MicroRally/Isolator-Controller/README.md

# Isolator Controller
 Isolator relay controller
