MicroRally/Isolator-Controller/Hardware/r4/Isolator_controller_r4_MODEL.step

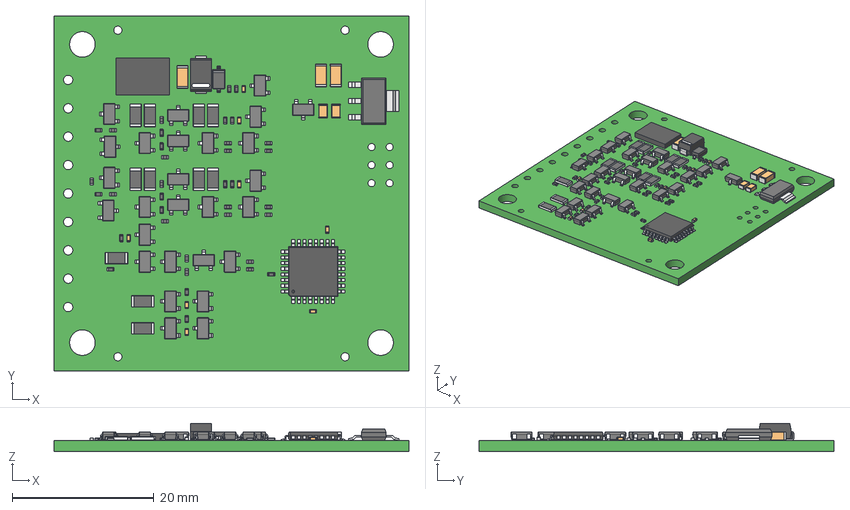
[picture p1: CAD file, 2021-09-15]
Hardware/r4/Isolator_controller_r4_MODEL.step
50.0 x 50.0 x 4.01 mm
SOT23-3 x 27
DO214AC-SMA
RESC0402_v2 x 36
SOT223-3 x 5
TQFP_32
RESC1206_v1 x 11
Extruded
pin
pin(Mirror)
icbody
C0402_045 x 24
C0805_085 x 6
C1206_120 x 9
