MicroRally/Isolator-Controller/Hardware/r5/Isolator_controller_r5_MODEL.step

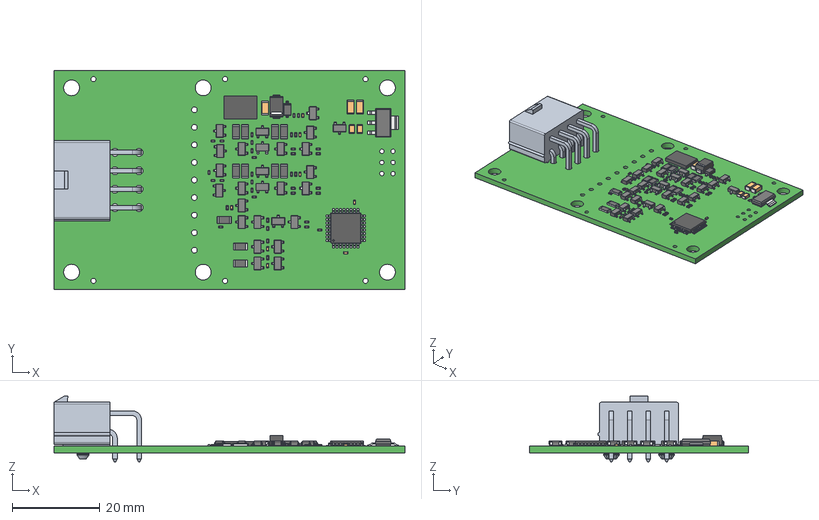
[picture p2: CAD file, 2022-07-29]
Hardware/r5/Isolator_controller_r5_MODEL.step
80.0 x 50.0 x 15.0 mm
SOT23-3 x 27
DO214AC-SMA
RESC0402_v2 x 36
SOT223-3 x 5
TQFP_32
RESC1206_v1 x 11
Extruded
pin
pin(Mirror)
icbody
C0402_045 x 24
C0805_085 x 6
C1206_120 x 9
