MicroRally/Isolator-Controller/Hardware/r5/Isolator_controller_r5_PCB.PDF

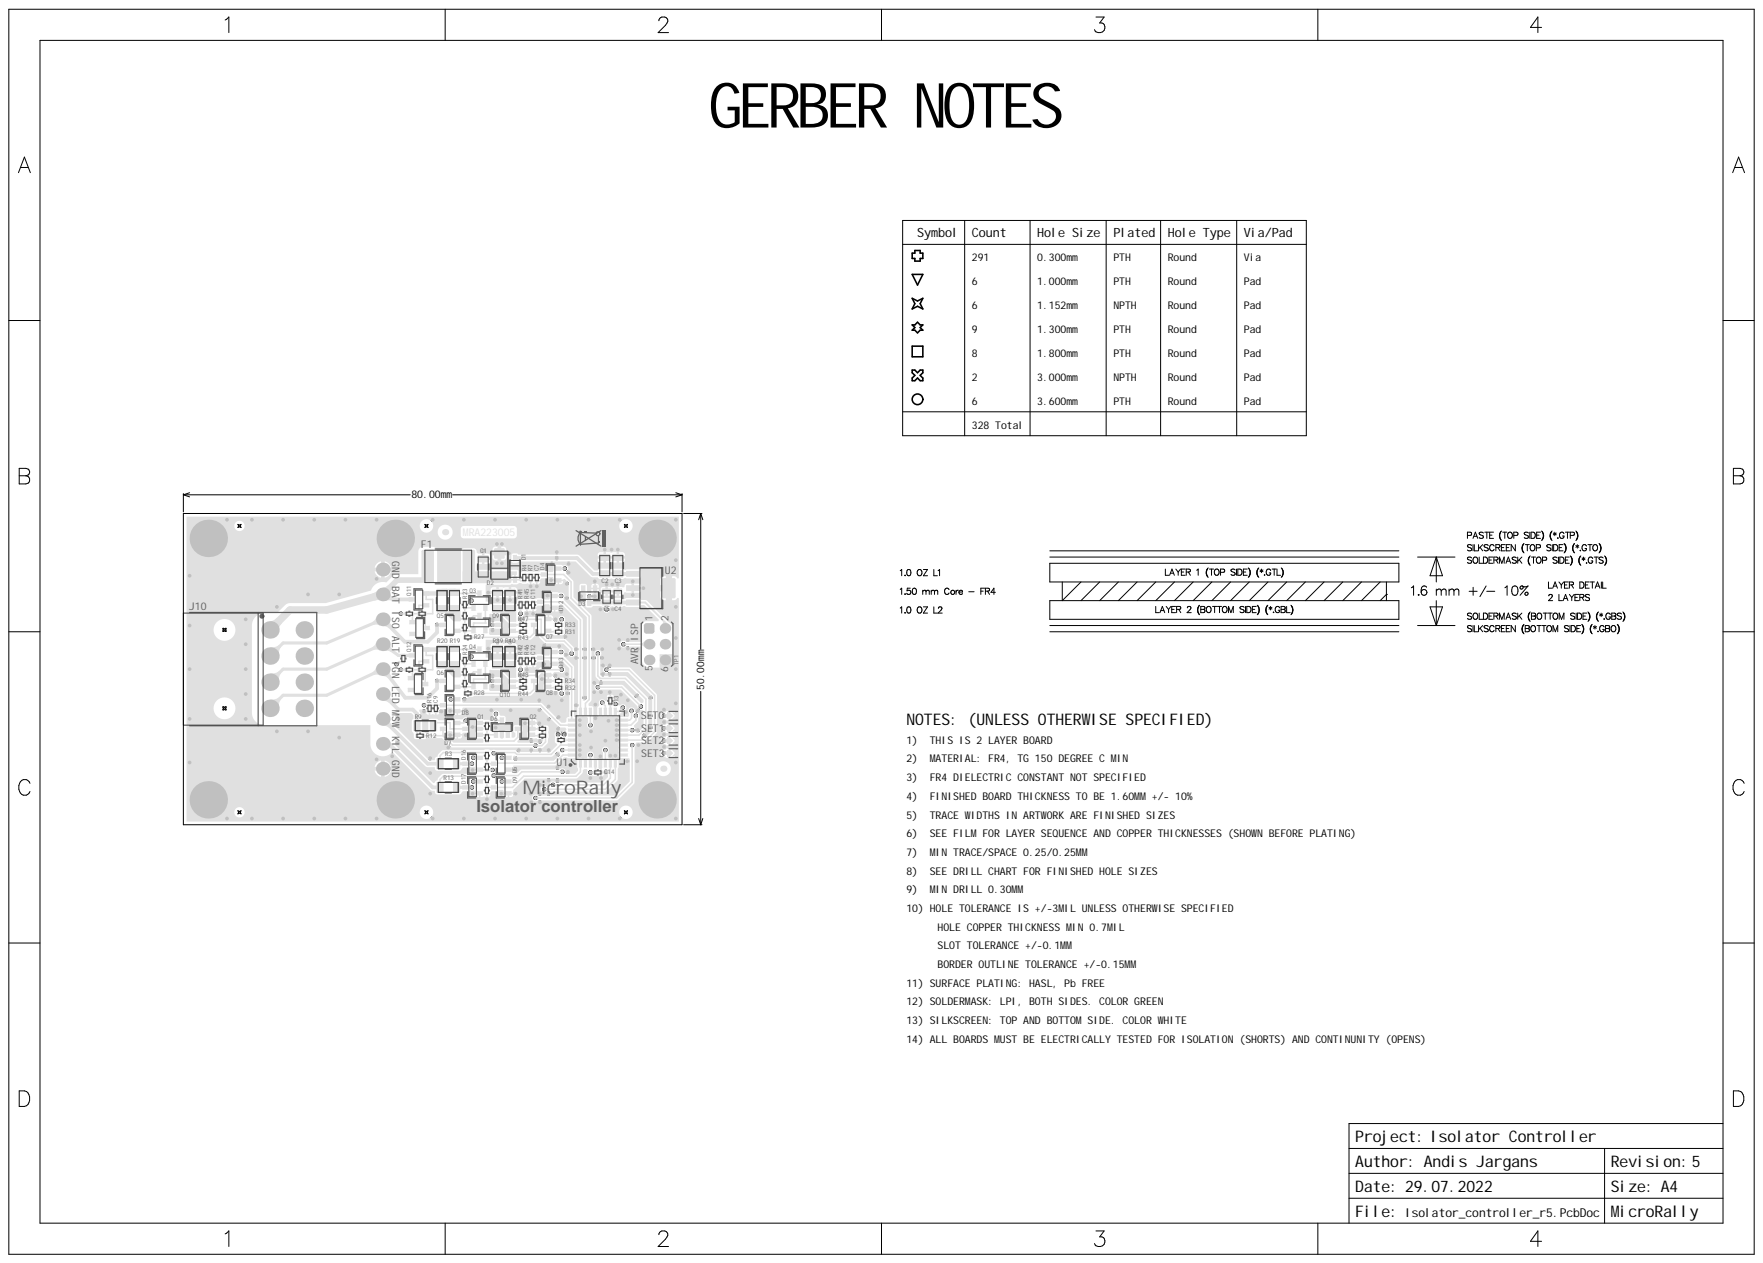
[picture p3: page 1]

Symbol | Count | Hole Size | Plated | Hole Type | Via/Pad

291 6 6 9 8 2 6 | 0.300mm 1.000mm 1.152mm 1.300mm 1.800mm 3.000mm 3.600mm | PTH PTH NPTH PTH PTH NPTH PTH | Round Round Round Round Round Round Round | Via Pad Pad Pad Pad Pad Pad

328 Total

GND BAT ISO ALT IGN LED MSW KIL GND

NOTES: (UNLESS OTHERWISE SPECIFIED)

1) THIS IS 2 LAYER BOARD
2) MATERIAL: FR4, TG 150 DEGREE C MIN
3) FR4 DIELECTRIC CONSTANT NOT SPECIFIED
4) FINISHED BOARD THICKNESS TO BE 1.60MM +/- 10%
5) TRACE WIDTHS IN ARTWORK ARE FINISHED SIZES
6) SEE FILM FOR LAYER SEQUENCE AND COPPER THICKNESSES (SHOWN BEFORE PLATING)
7) MIN TRACE/SPACE 0.25/0.25MM
8) SEE DRILL CHART FOR FINISHED HOLE SIZES
9) MIN DRILL 0.30MM
10) HOLE TOLERANCE IS +/-3MIL UNLESS OTHERWISE SPECIFIED
HOLE COPPER THICKNESS MIN 0.7MIL
SLOT TOLERANCE +/-0.1MM
BORDER OUTLINE TOLERANCE +/-0.15MM
11) SURFACE PLATING: HASL, Pb FREE
12) SOLDERMASK: LPI, BOTH SIDES. COLOR GREEN
13) SILKSCREEN: TOP AND BOTTOM SIDE. COLOR WHITE
14) ALL BOARDS MUST BE ELECTRICALLY TESTED FOR ISOLATION (SHORTS) AND CONTINUNITY (OPENS)

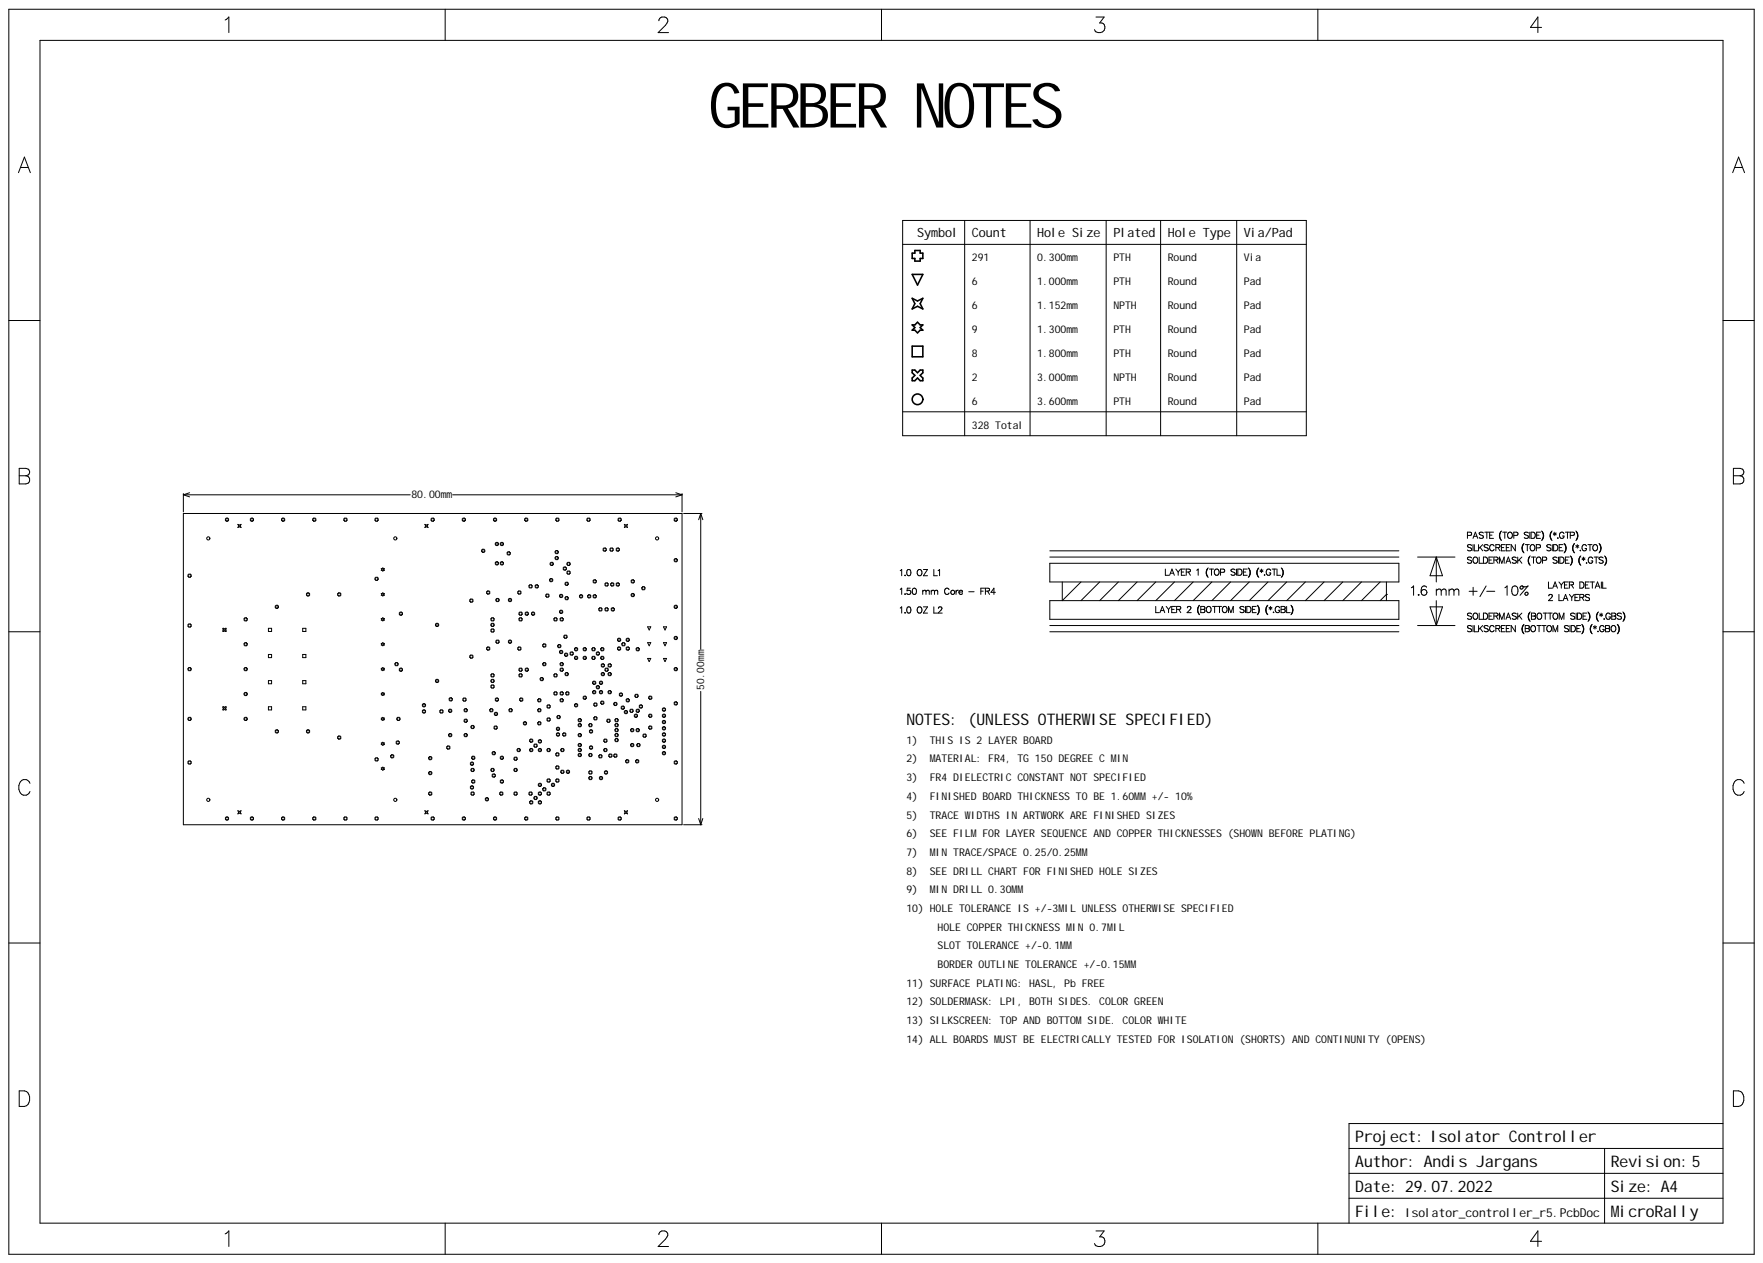
[picture p4: page 2]

Symbol | Count | Hole Size | Plated | Hole Type | Via/Pad

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

328 Total

NOTES: (UNLESS OTHERWISE SPECIFIED)

1) THIS IS 2 LAYER BOARD
2) MATERIAL: FR4, TG 150 DEGREE C MIN
3) FR4 DIELECTRIC CONSTANT NOT SPECIFIED
4) FINISHED BOARD THICKNESS TO BE 1.60MM +/- 10%
5) TRACE WIDTHS IN ARTWORK ARE FINISHED SIZES
6) SEE FILM FOR LAYER SEQUENCE AND COPPER THICKNESSES (SHOWN BEFORE PLATING)
7) MIN TRACE/SPACE 0.25/0.25MM
8) SEE DRILL CHART FOR FINISHED HOLE SIZES
9) MIN DRILL 0.30MM
10) HOLE TOLERANCE IS +/-3MIL UNLESS OTHERWISE SPECIFIED
HOLE COPPER THICKNESS MIN 0.7MIL
SLOT TOLERANCE +/-0.1MM
BORDER OUTLINE TOLERANCE +/-0.15MM
11) SURFACE PLATING: HASL, Pb FREE
12) SOLDERMASK: LPI, BOTH SIDES. COLOR GREEN
13) SILKSCREEN: TOP AND BOTTOM SIDE. COLOR WHITE
14) ALL BOARDS MUST BE ELECTRICALLY TESTED FOR ISOLATION (SHORTS) AND CONTINUNITY (OPENS)

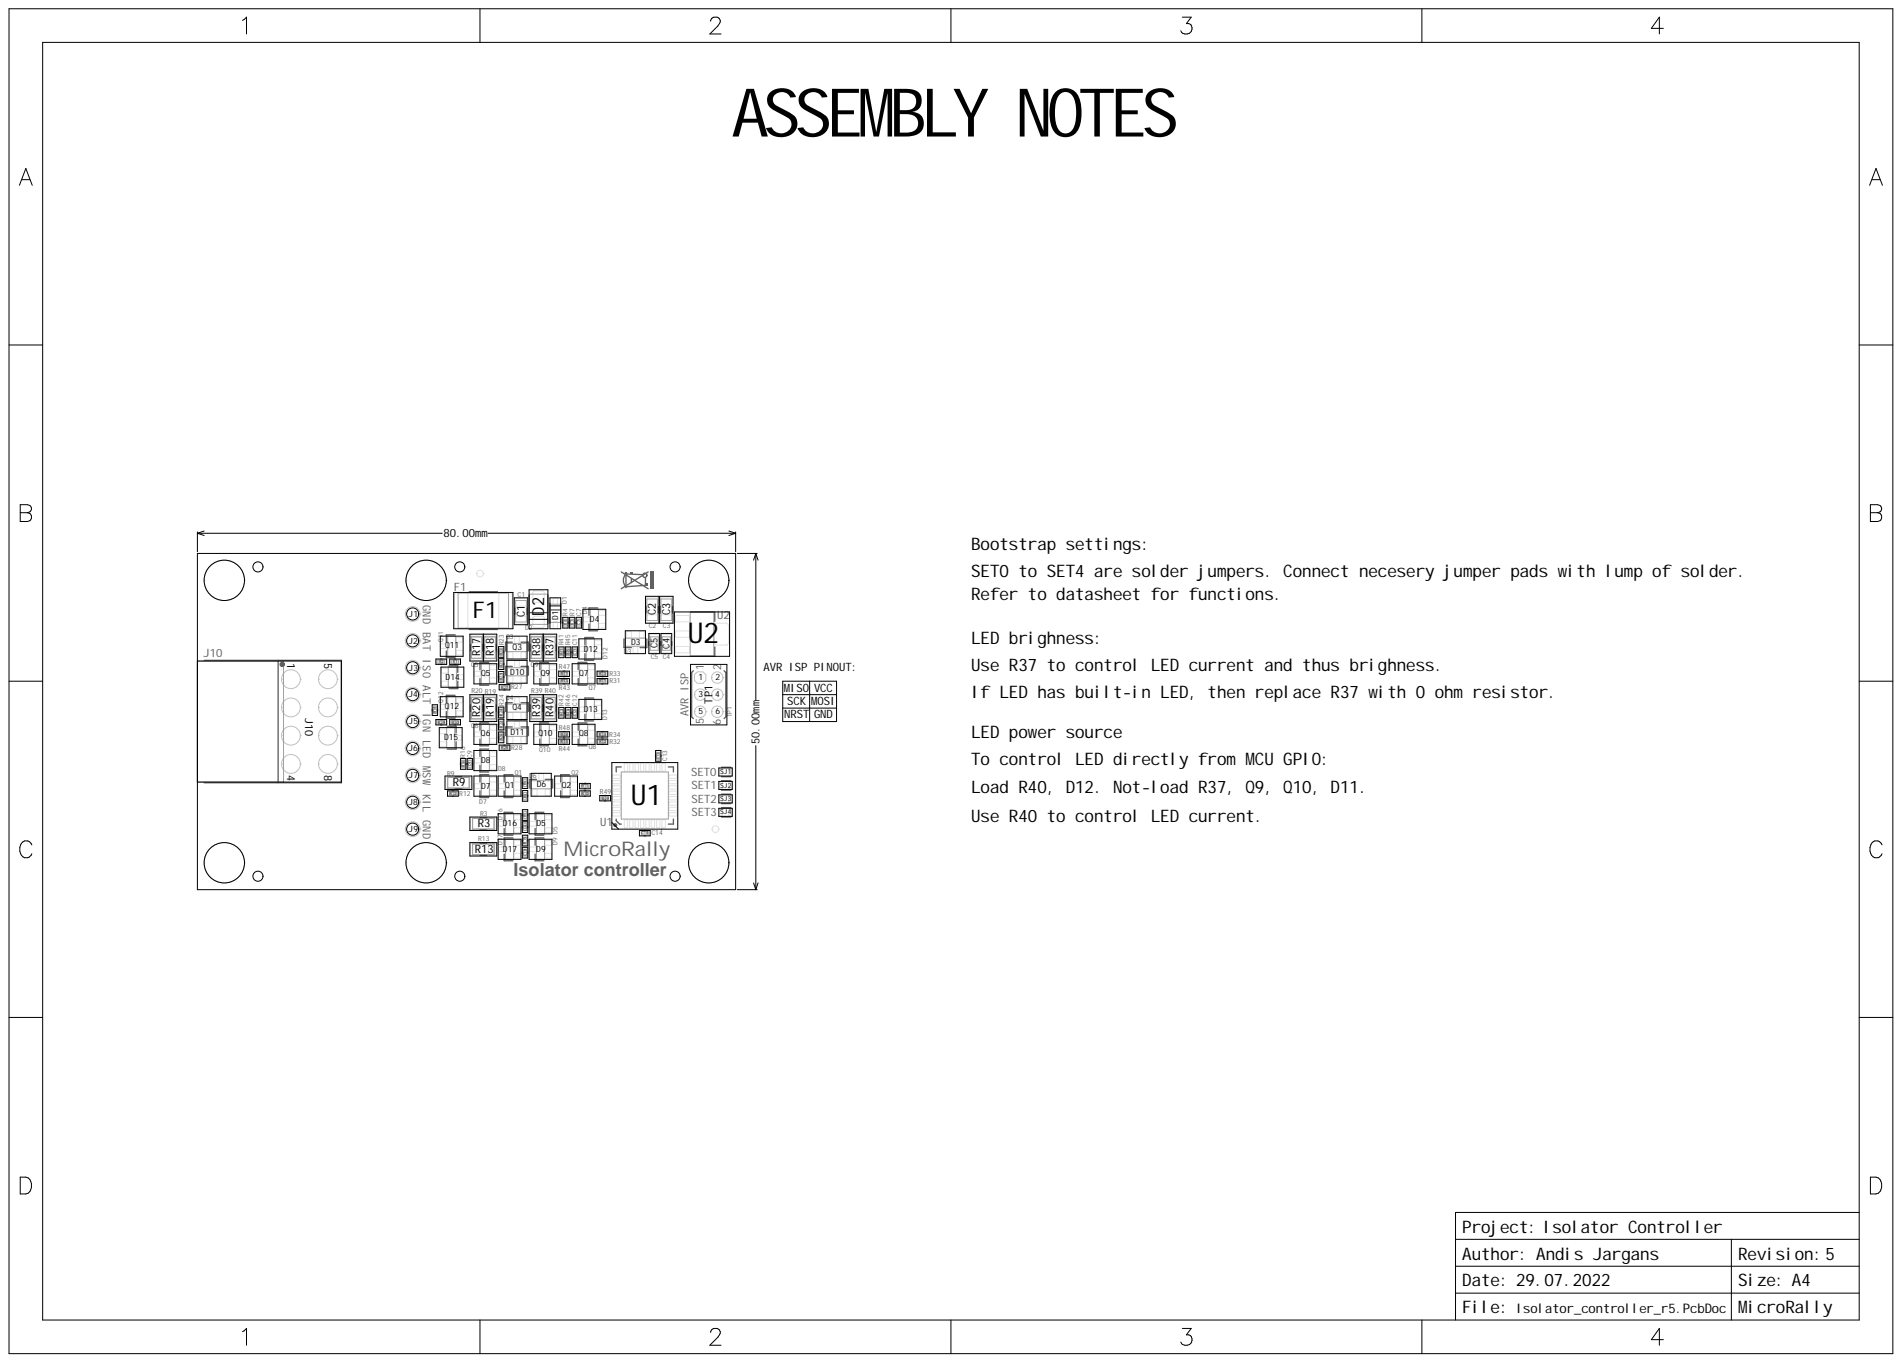
[picture p5: page 3]

Bootstrap settings:
SET0 to SET4 are solder jumpers. Connect necesery jumper pads with lump of solder.
Refer to datasheet for functions.

GND BAT ISO ALT IGN LED MSW KIL GND

LED brighness:
Use R37 to control LED current and thus brighness.

If LED has built-in LED, then replace R37 with 0 ohm resistor.

LED power source
To control LED directly from MCU GPIO:
Load R40, D12. Not-load R37, Q9, Q10, D11.
Use R40 to control LED current.

Author: Andis Jargans | Revision: 5
Date: 29.07.2022 | Size: A4

File: Isolator_controller_r5.PcbDoc | MicroRally

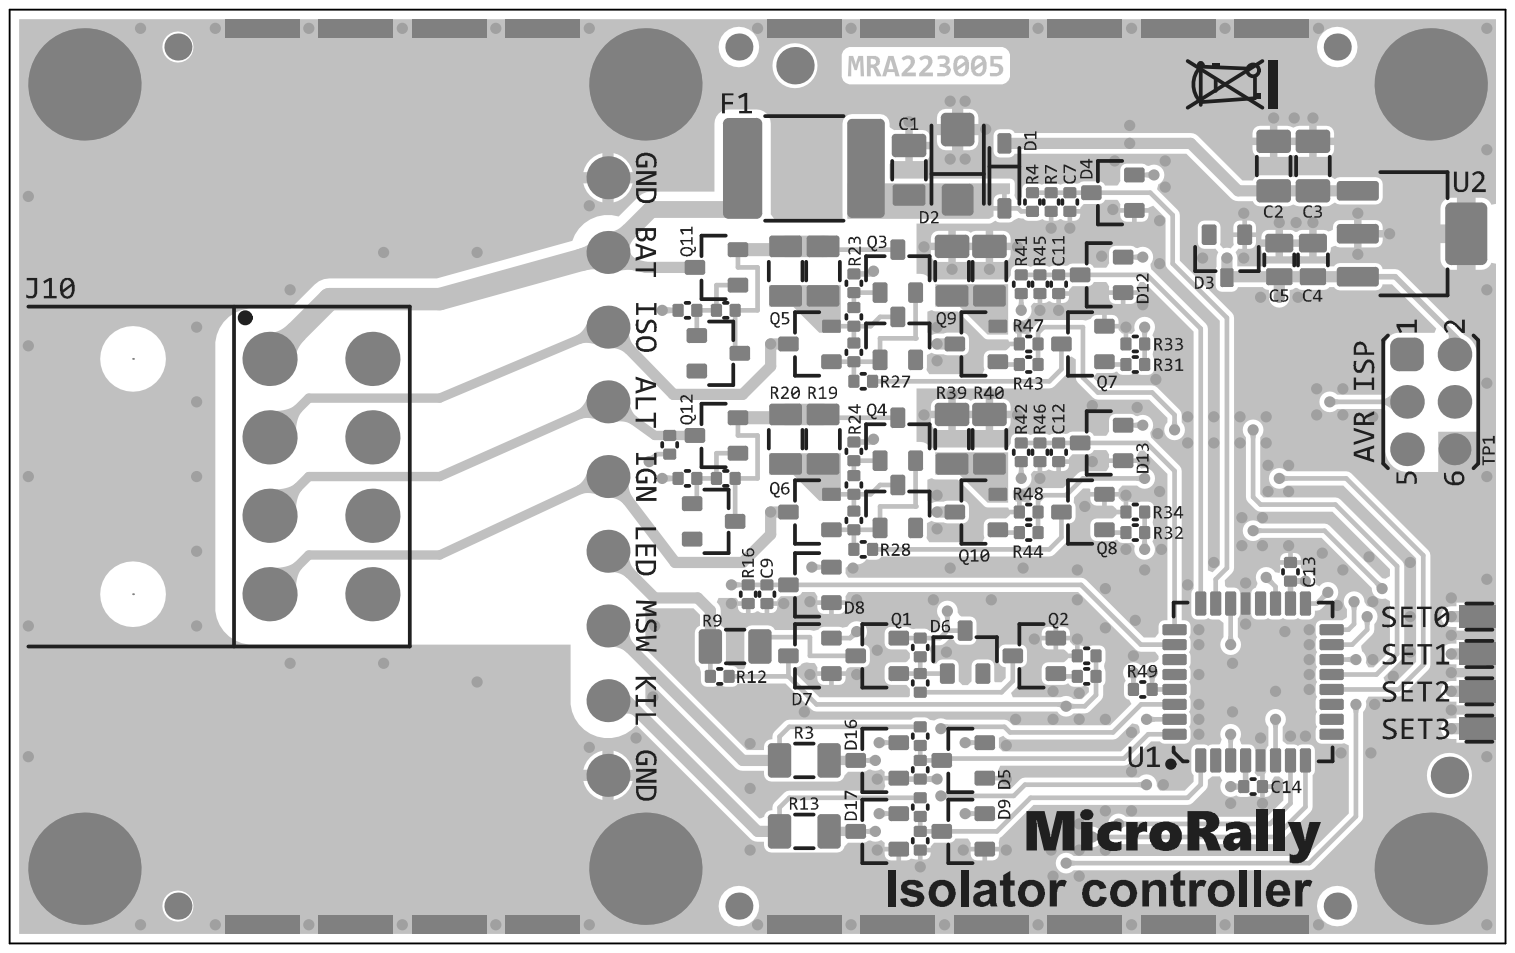
[picture p6: page 4]

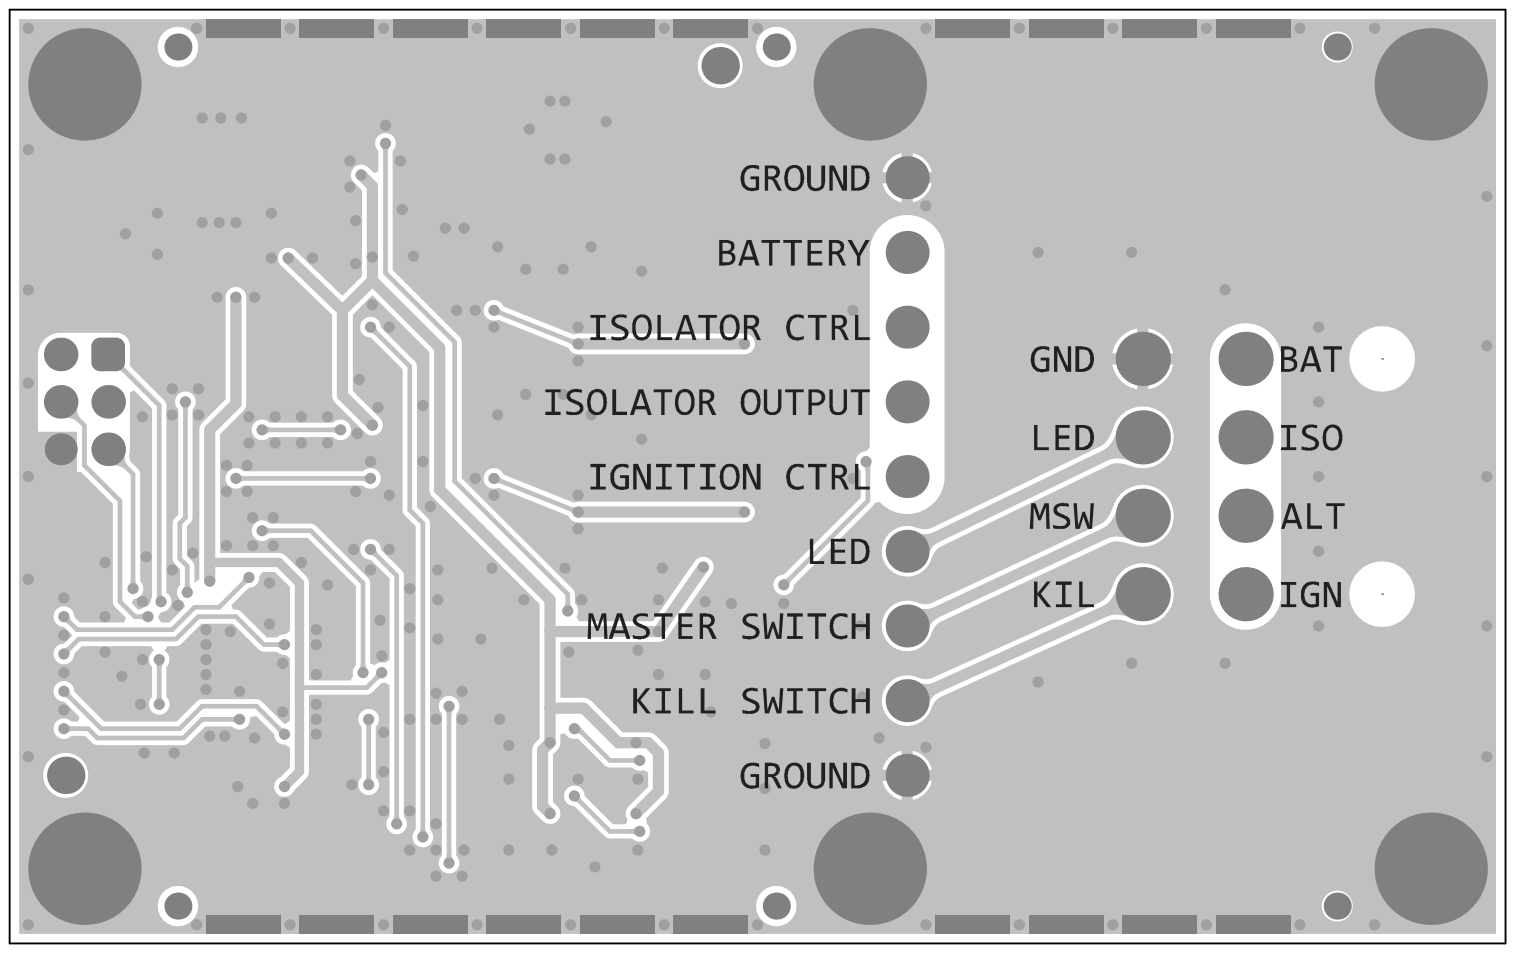
[picture p7: page 5]

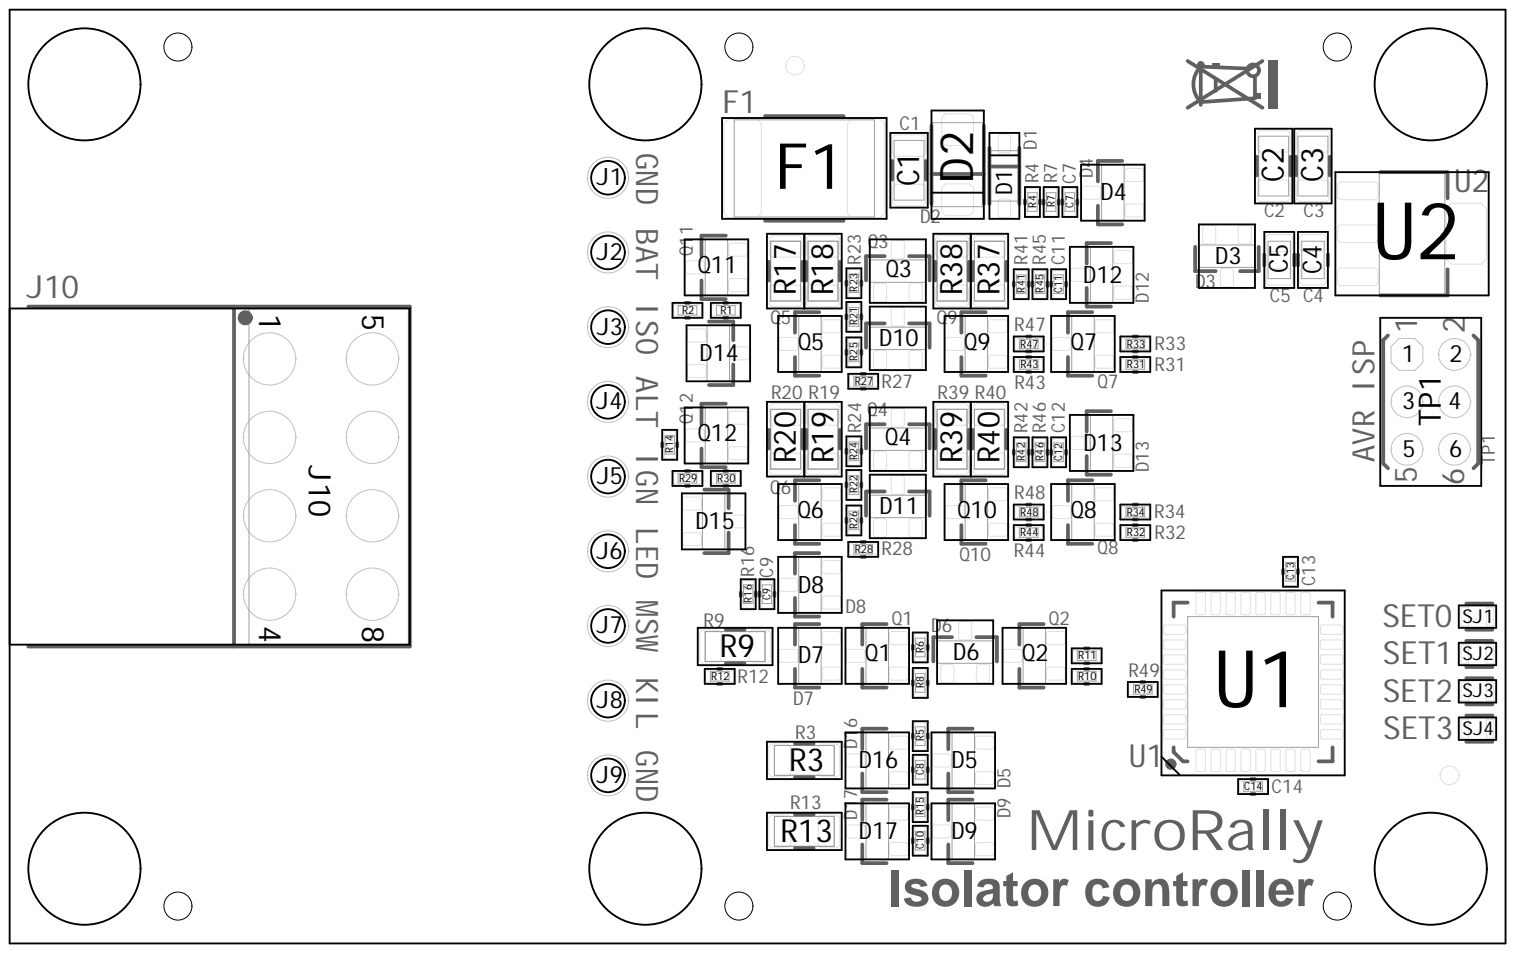
[picture p8: page 6]

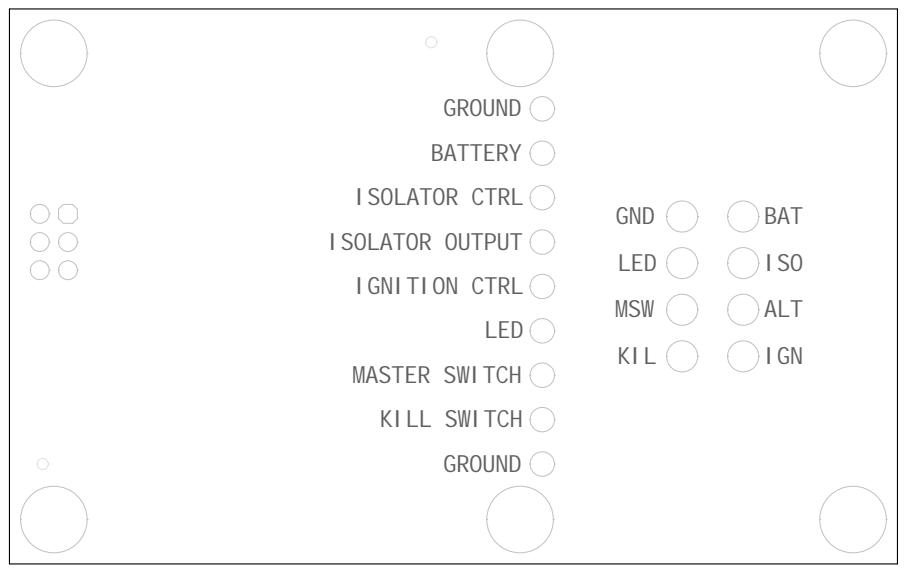
[picture p9: page 7]

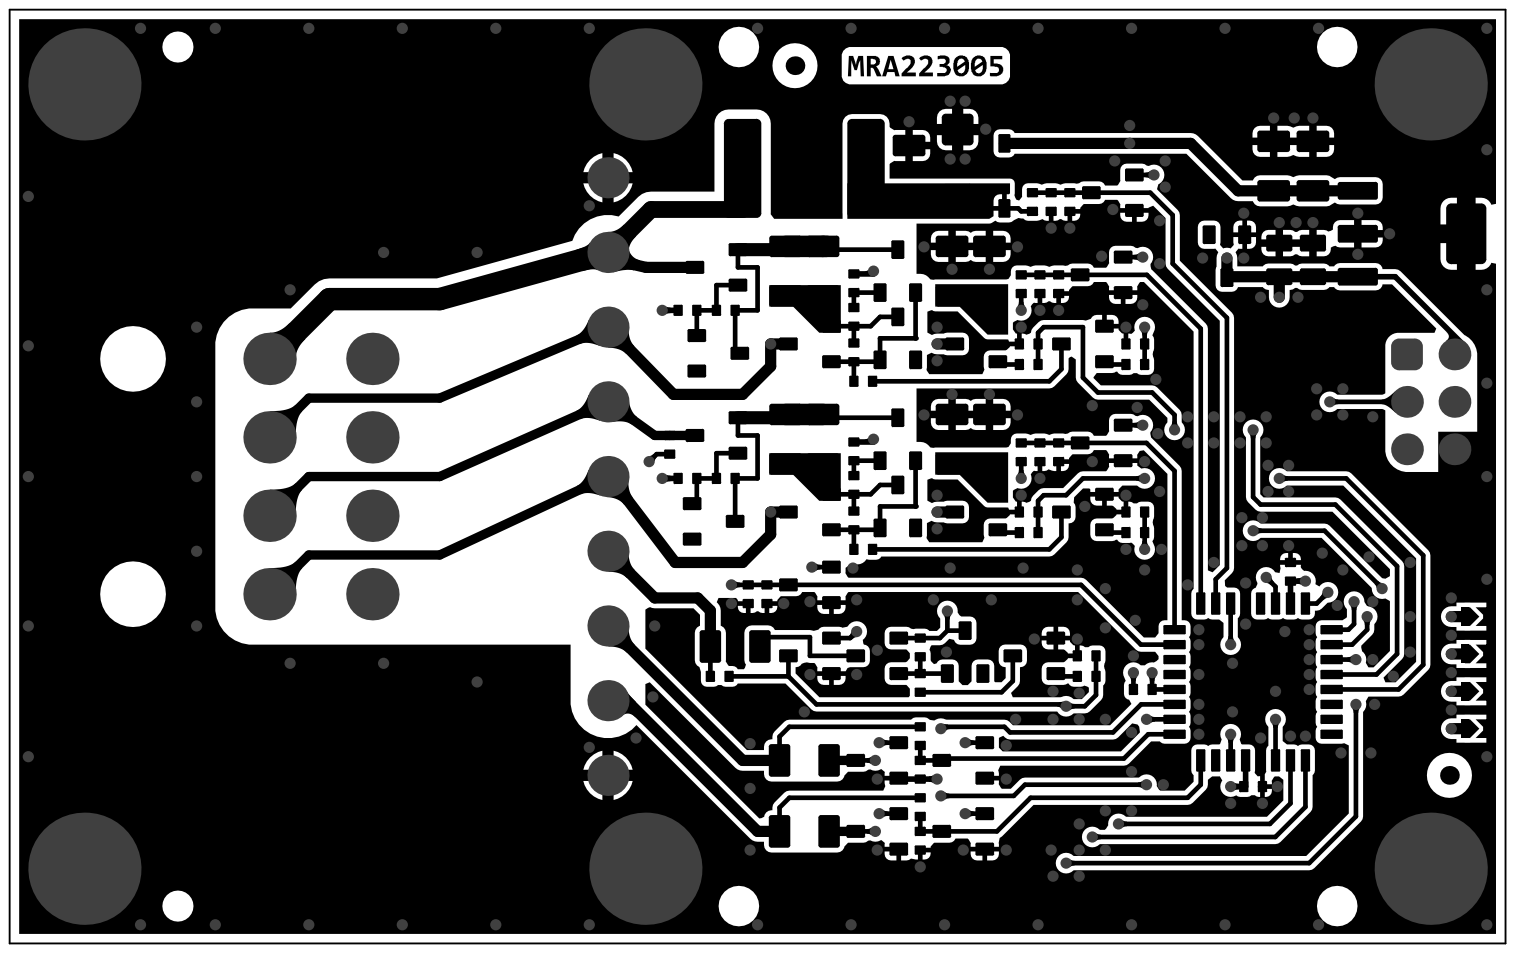
[picture p10: page 8]

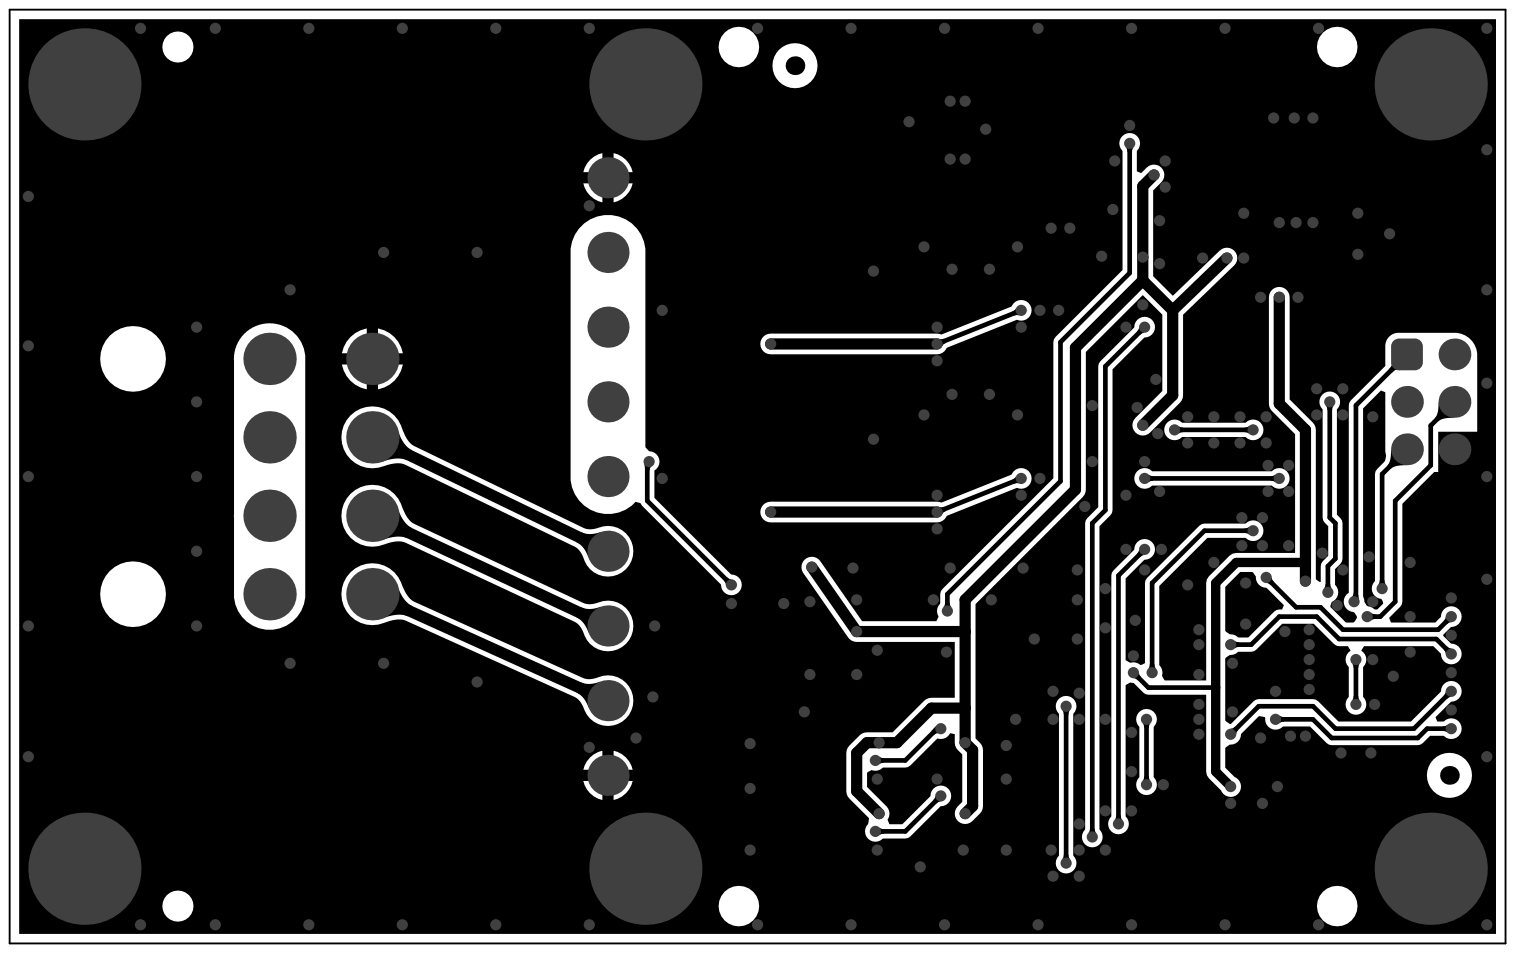
[picture p11: page 9]

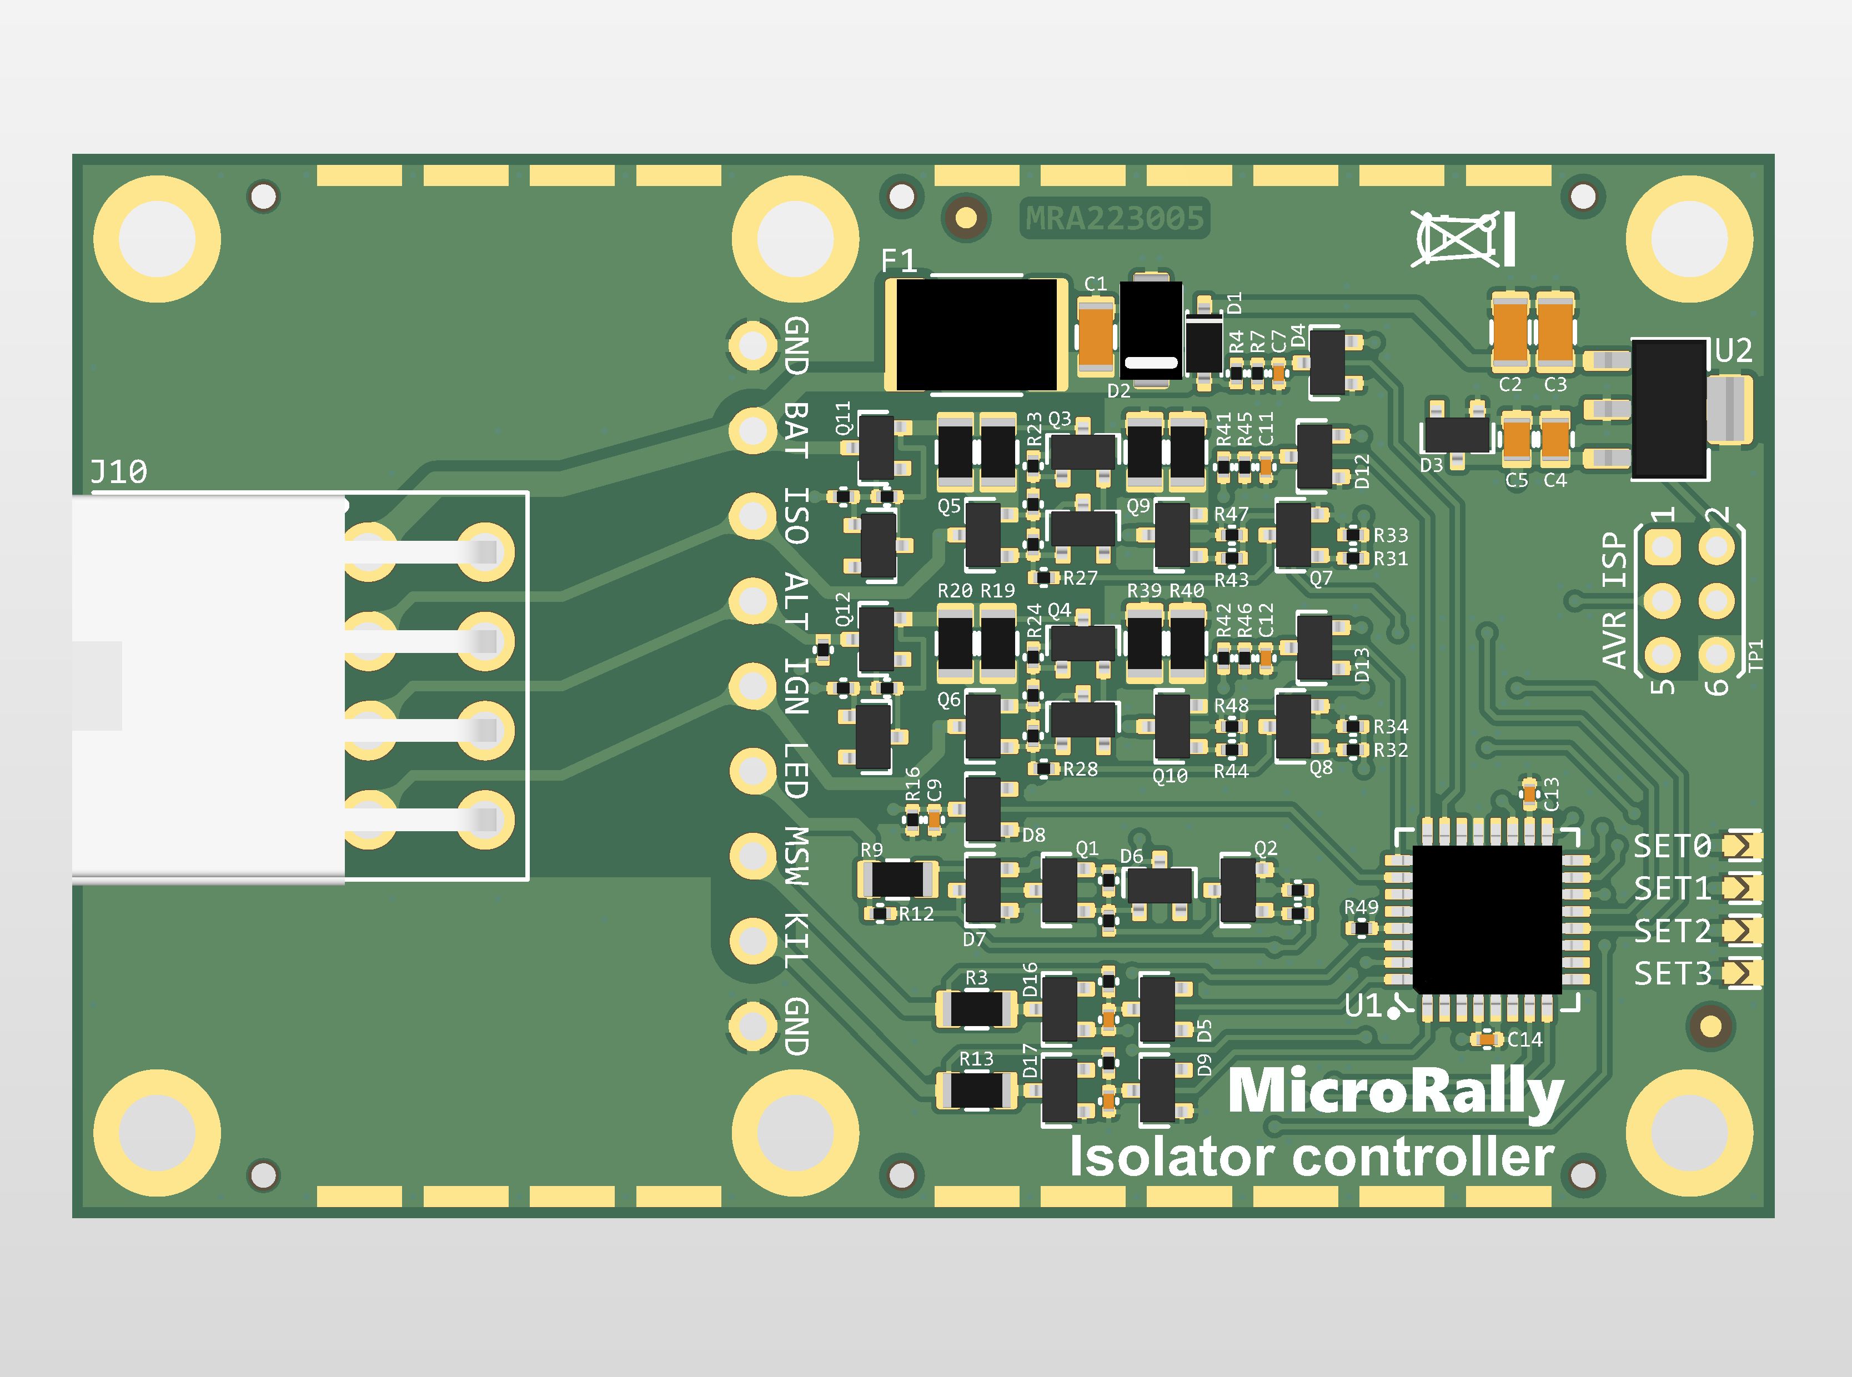
[picture p12: page 10]

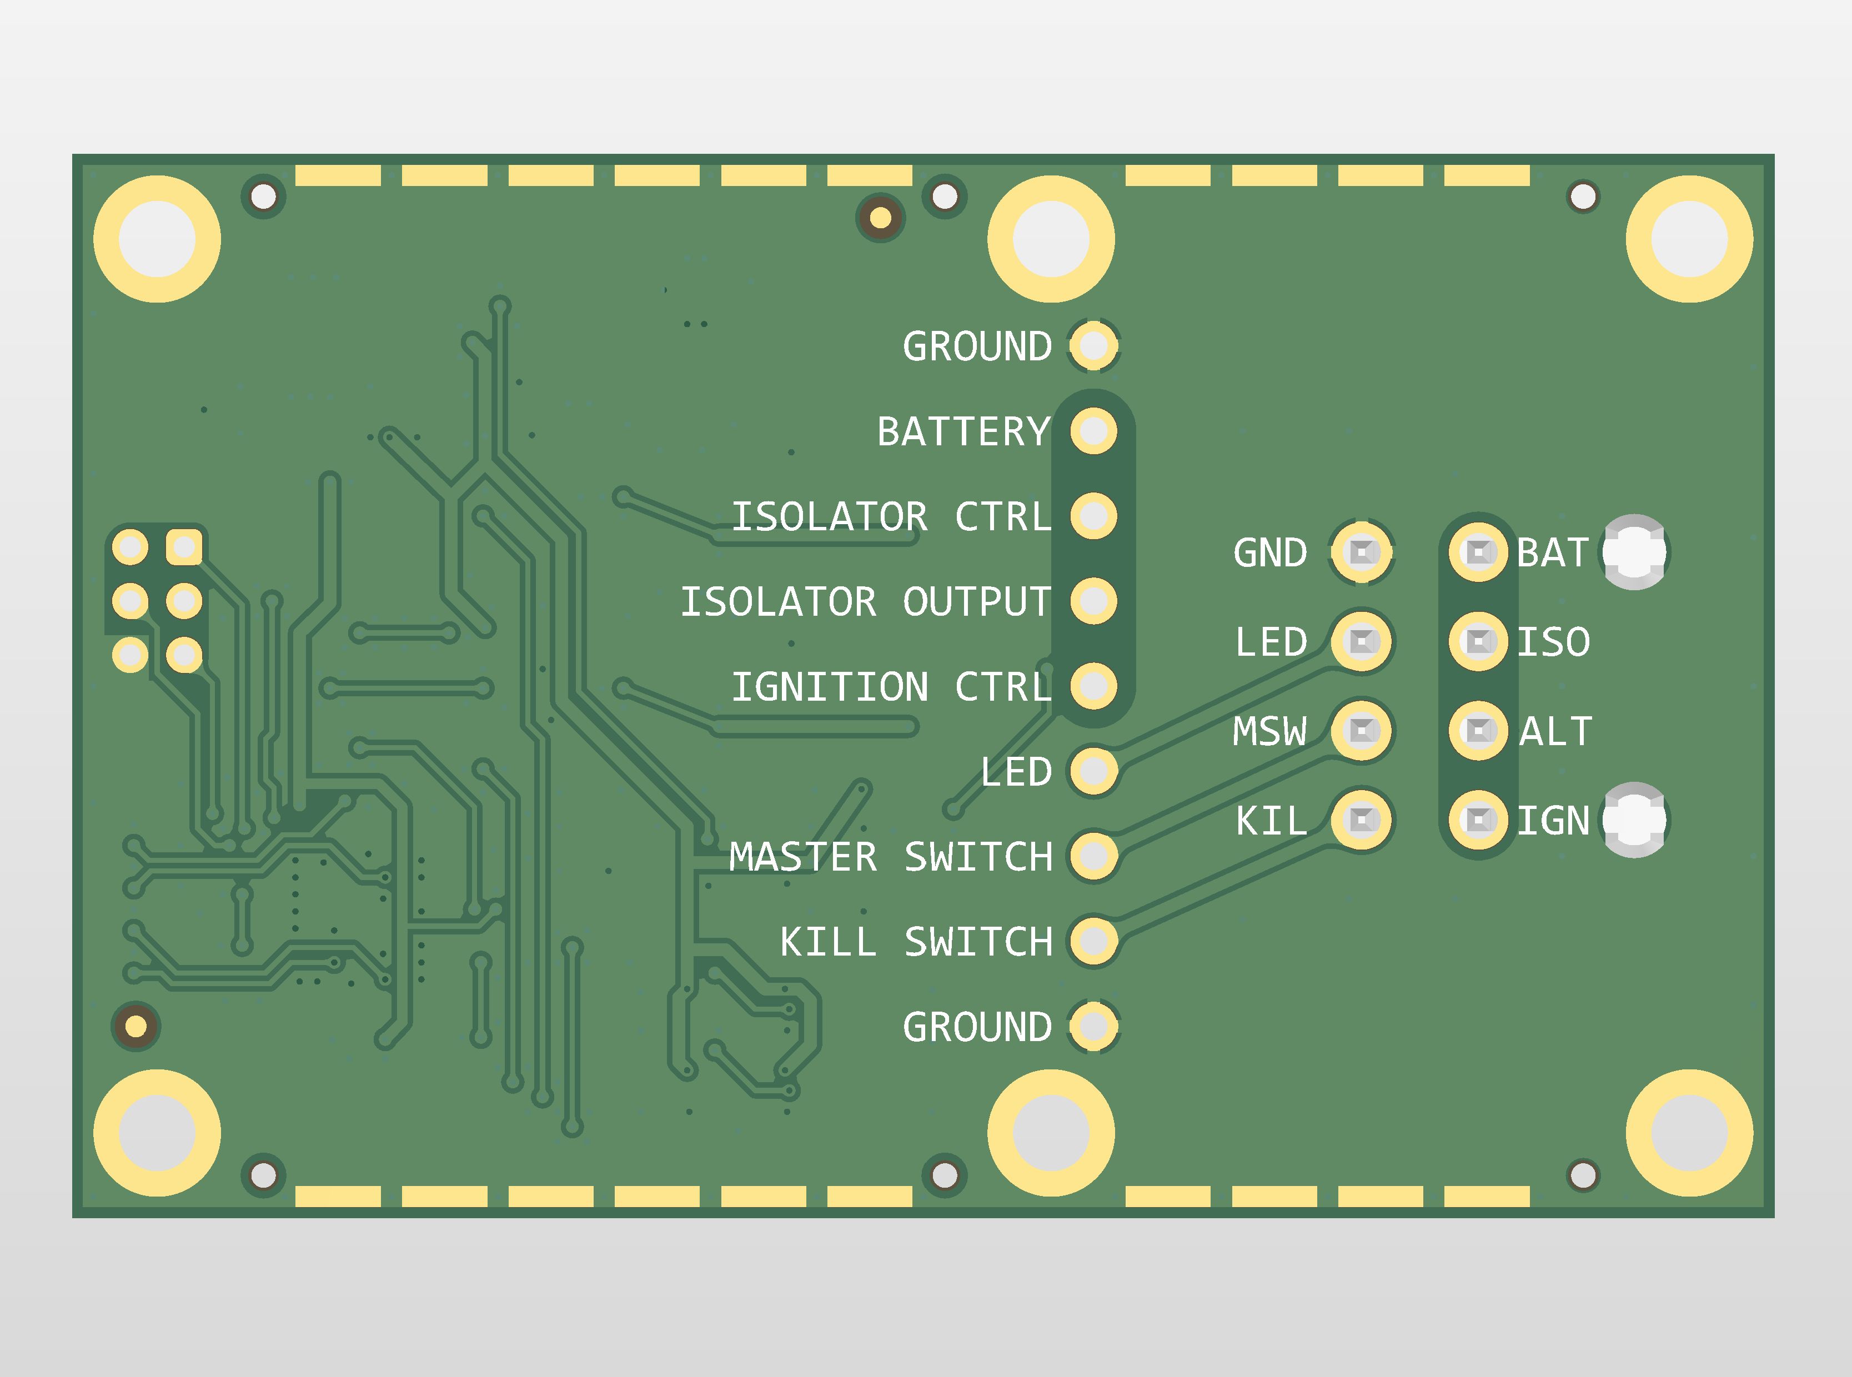
[picture p13: page 11]

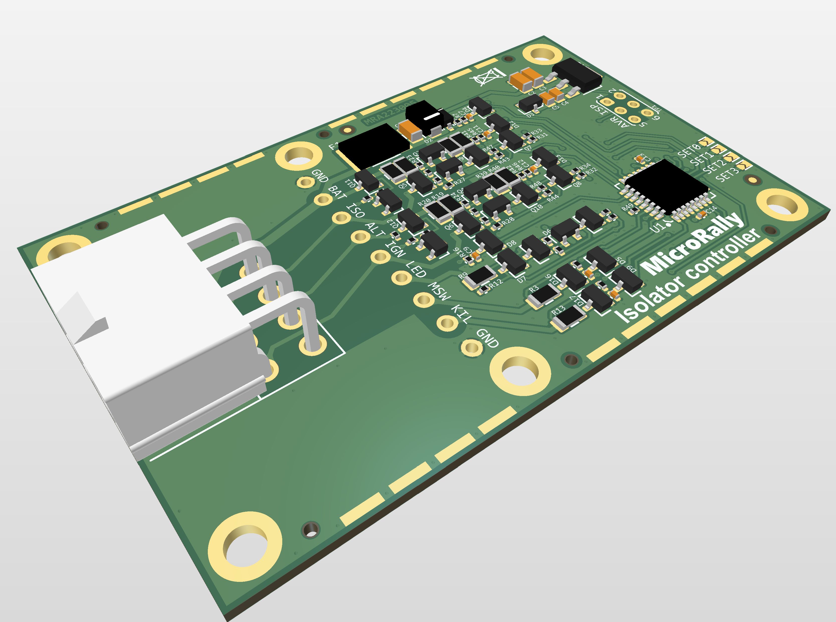
[picture p14: page 12]
