MicroRally/Isolator-Controller/Hardware/r4/Isolator_controller_r4_Schematics.PDF

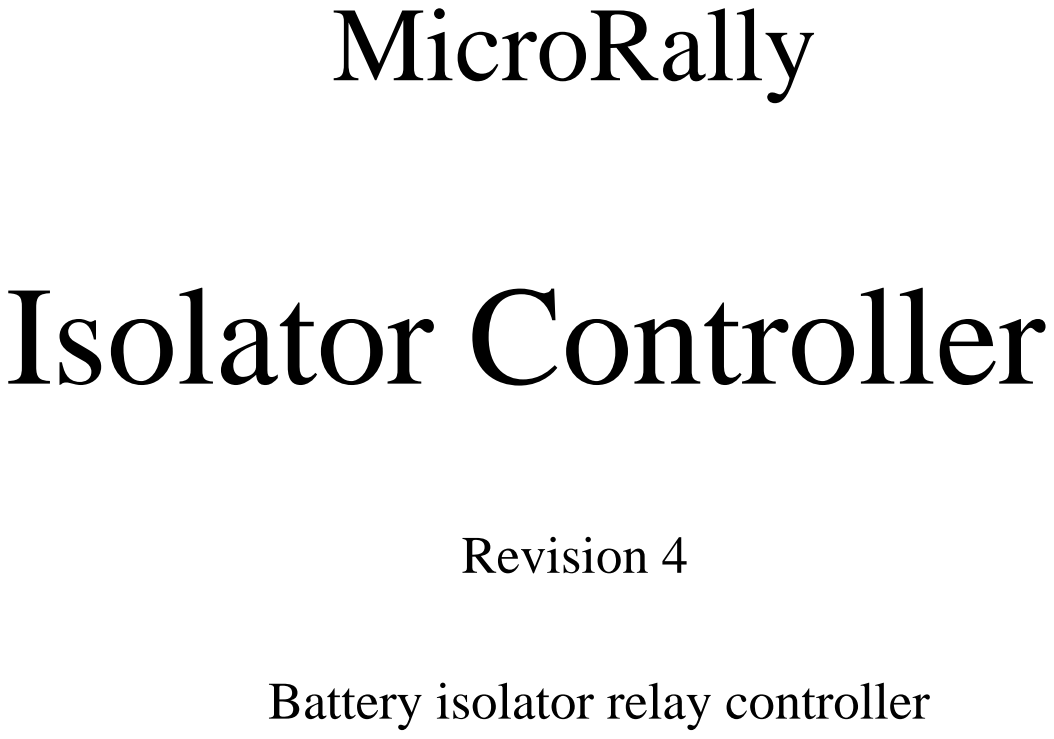
[picture p32: page 1]

Battery isolator relay controller

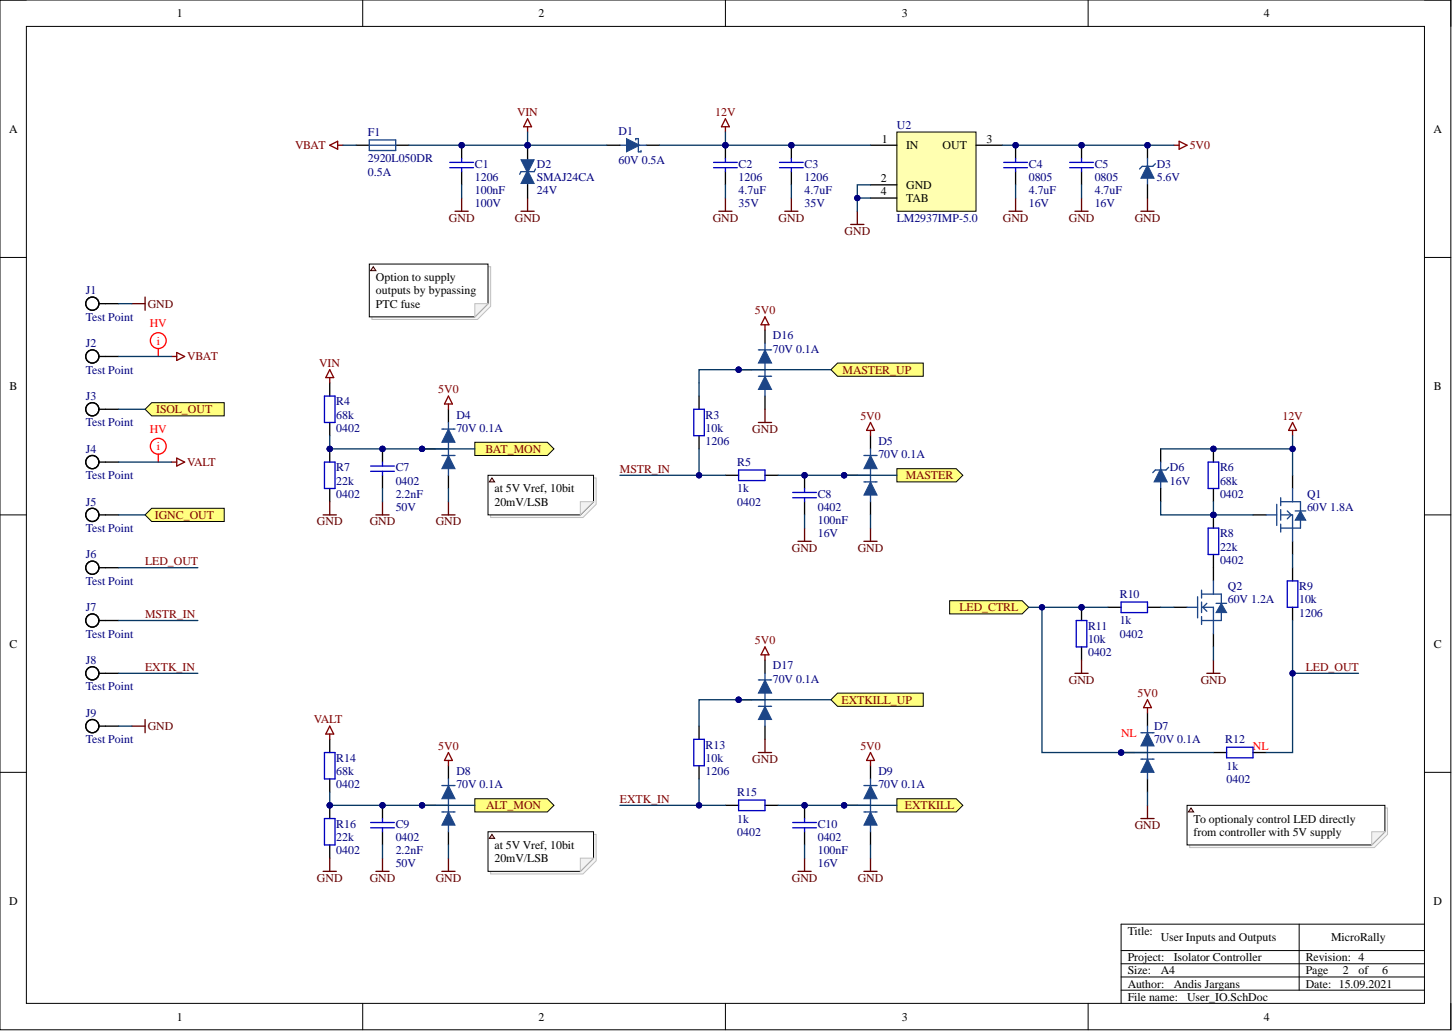
[picture p33: page 2]

To optionaly control LED directly
from controller with 5V supply

File name: Author: Size:

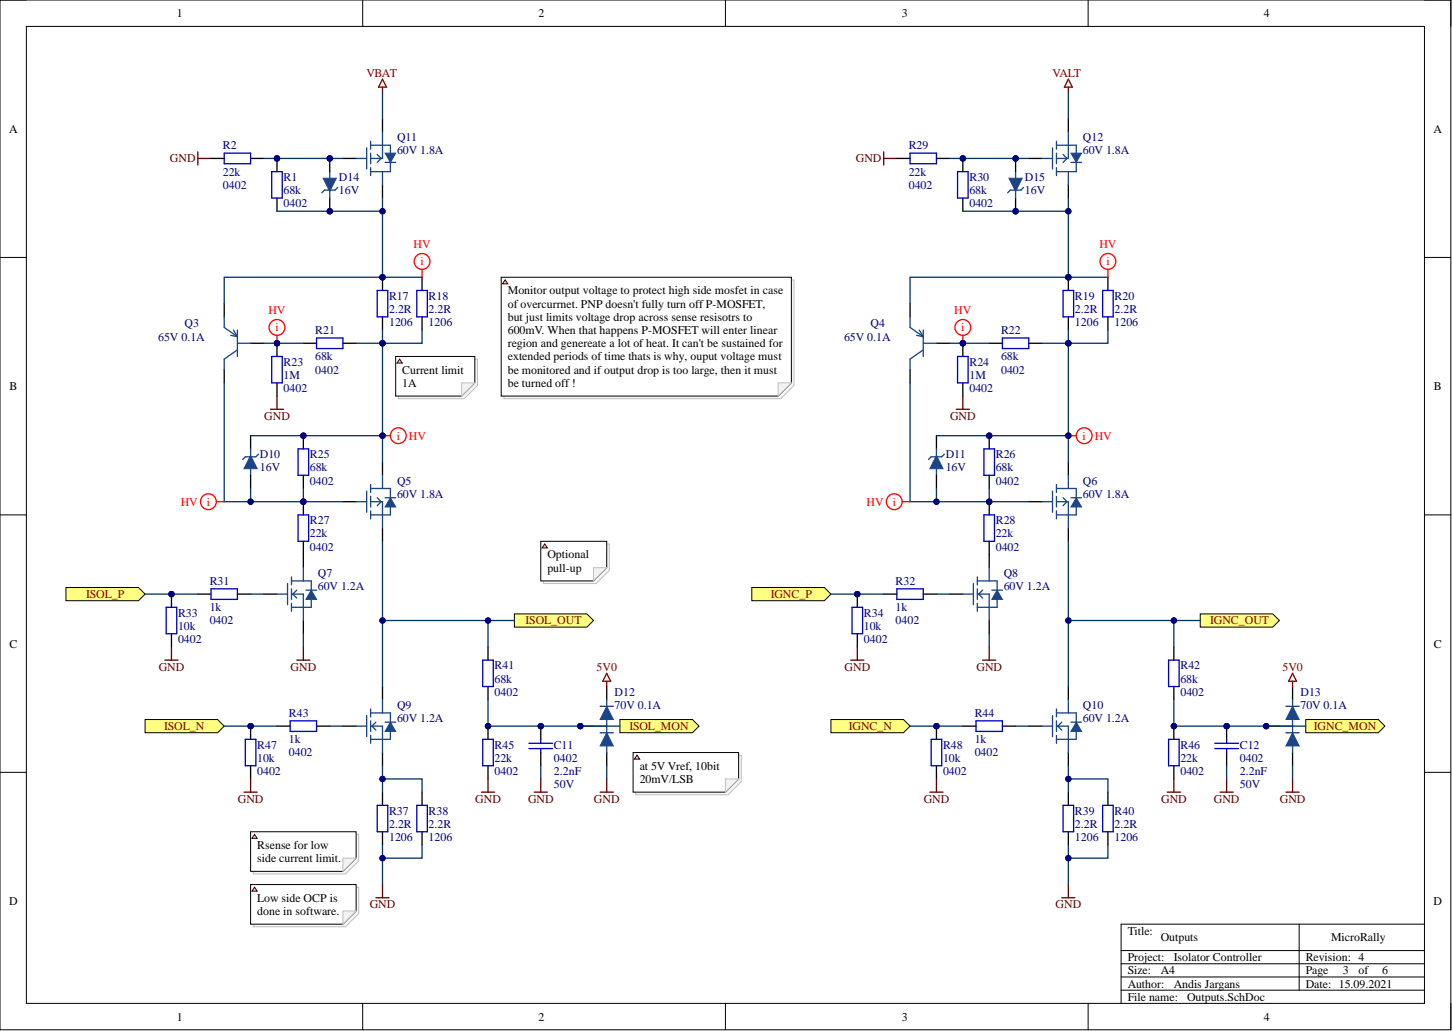
[picture p34: page 3]

Monitor output voltage to protect high side mosfet in case
of overcurrnet. PNP doesn't fully turn off P-MOSFET,
but just limits voltage drop across sense resisotrs to
600mV. When that happens P-MOSFET will enter linear
region and genereate a lot of heat. It can't be sustained for
extended periods of time thats is why, ouput voltage must
be monitored and if output drop is too large, then it must
be turned off !

Low side OCP is
done in software.

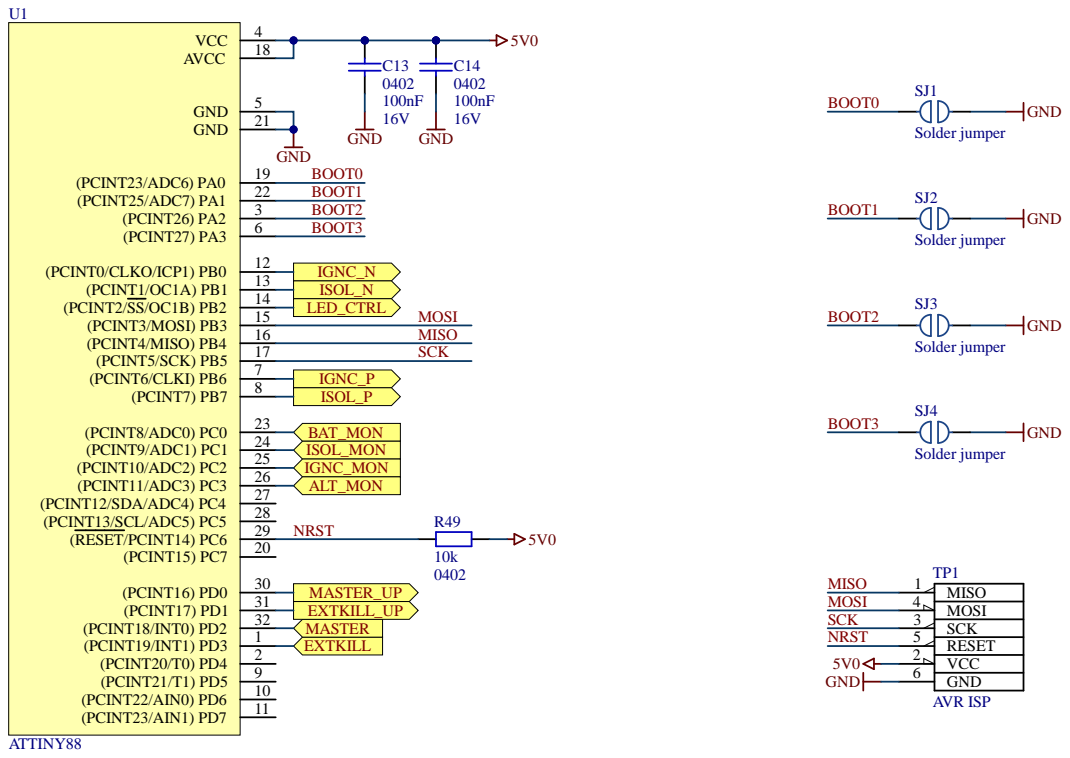
[picture p35: page 4]

Solder jumper SJ1 Solder jumper SJ2 Solder jumper SJ3 Solder jumper SJ4

File name: Author: Size:

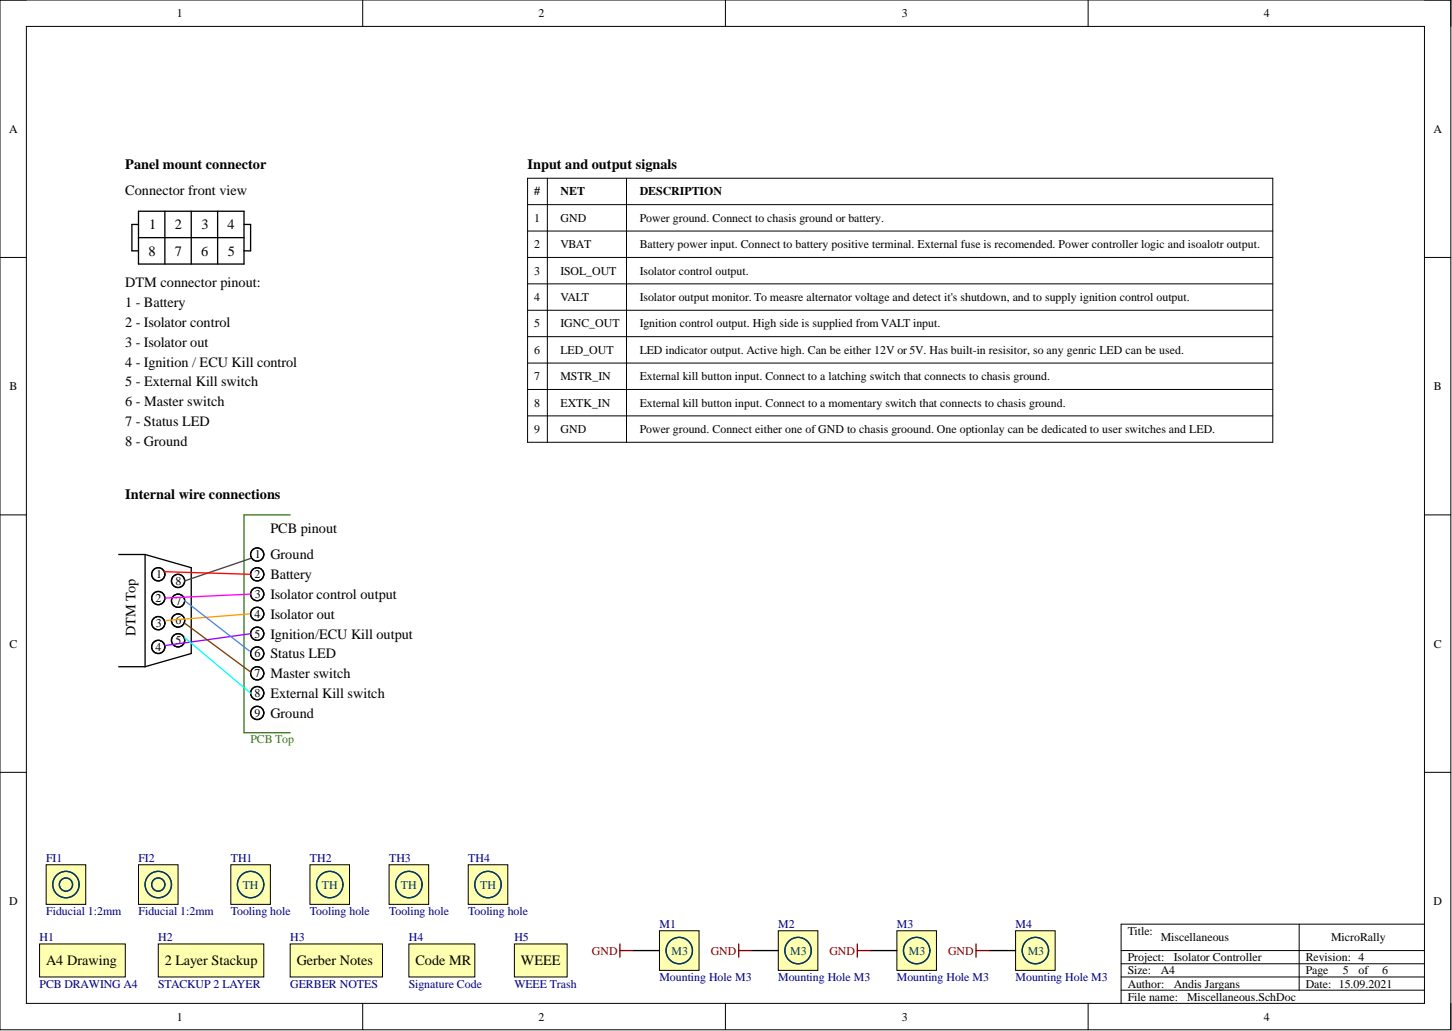
[picture p36: page 5]

Input and output signals

# | NET | DESCRIPTION

1 | GND | Power ground. Connect to chasis ground or battery.

2 | VBAT | Battery power input. Connect to battery positive terminal. External fuse is recomended. Power controller logic and isoalotr output.

3 | ISOL_OUT | Isolator control output.

DTM connector pinout:
1 - Battery
2 - Isolator control
3 - Isolator out
4 - Ignition / ECU Kill control
5 - External Kill switch
6 - Master switch
7 - Status LED
8 - Ground

4 | VALT | Isolator output monitor. To measre alternator voltage and detect it's shutdown, and to supply ignition control output.

5 | IGNC_OUT | Ignition control output. High side is supplied from VALT input.

6 | LED_OUT | LED indicator output. Active high. Can be either 12V or 5V. Has built-in resisitor, so any genric LED can be used.

7 | MSTR_IN | External kill button input. Connect to a latching switch that connects to chasis ground.

8 | EXTK_IN | External kill button input. Connect to a momentary switch that connects to chasis ground.

9 | GND | Power ground. Connect either one of GND to chasis groound. One optionlay can be dedicated to user switches and LED.

D | D
C | C
B | B
A | A

Title:

History.SchDoc

Revision history | MicroRally

## Revision history

Revison | Date | Fixed issue | Changes
r1 | 2020-07-21 | | Initial design.
r2 | 2021-04-01 | | Bootstrap resistors changed to sloder jumpers.
| | Cleaner routing. | U1 ISOL_MON and IGNC_MON pins swapped.
| | Option to bypass fuse to VIN supply. | Added R42, R43.
r3 | 2021-06-01 | Isolator and Ignition control outputs are not reverse polarity protected. | Added Ideal diodes (P-ch mosfets) in inputs.
| | Ignition output relay in open-drain configuration could be activated in overvoltage scenario. | Ignition output stage voltage source changed to seperate source - isolator output supply.
| | Monitoring isolator ouput voltage could be useful. | Added isoaltor output voltage monitoring curcuit.
| | Add option to have combined master switch and LED indicator pin. | Added software controlable pull-up resistors for master switch and kill signals. LED cab be supplied through pull-up by changing pull-up to smaller value.
| | No fixed sense resistors for low side OCP. | Added low side sense resistors for easier software controlled low side OCP.
| | | Changed controller pinout. NOT reverse compatable with older SW versions !
| | | Changed PCB "connector" from 8pin 2.54mm pitch to 9 custom pads. Changed pinout.
| | Output combined current can exceed PTC fuse current. | Push-pull outputs changed to be supplied directly from supply pins. Removed option to supply through PTC fuse.

Increase distance between pads.

New layout and added functionality.

r4 | 2021-09-15 | OCP detection isn't fast enough. LPF created form voltage dividers has too much capacitance. | Reduced voltage dividers capacitance to 2.2nF, creating step response in about 1ms.
| | MOSFET gates sometimes get damaged during short circuit. | Lowered zener diode voltage to 16V.
| | Bootstrap solder-jumper are too hard to solder. | Changed solder jumper pad shape.
