MicroRally/Isolator-Controller/Firmware/Drivers/adc_driver.h

/*
Battery isolator controller
ADC driver

Author: Andis Jargans

Revision history:
2021-09-14: Initial version
*/

#ifndef ADC_DRIVER
#define ADC_DRIVER

/**** Includes ****/

/**** Public definitions ****/
#define ADC_BATU	0
#define ADC_ISOL	1
#define ADC_IGNC	2
#define ADC_ALTU	3

/**** Public function declarations ****/
//Control functions
void ADCDRV_Init(uint8_t wake);
void ADCDRV_Wake(void);
void ADCDRV_Sleep(void);

//Interrupt and loop functions
void ADCDRV_MeasureAll(void);

//Data retrieve functions
uint16_t ADCDRV_GetValue(uint8_t ch);

#endif
