MicroRally/Isolator-Controller/(commit log)

2021-09-15 Initial add
    Initial add of design files and firmware v1.0
    [Isolator_controller_r4_BOM.xlsx, Isolator_controller_r4_MODEL.step, Isolator_controller_r4_PNP.csv]
2022-07-29 Created PCB r5
    Created PCB version with cheaper, more available Molex MiniFit connector.
    [Isolator_controller_r4_BOM.xlsx, Isolator_controller_r4_MODEL.step, Isolator_controller_r4_PNP.csv, Isolator_controller_r5_BOM.xlsx, Isolator_controller_r5_MODEL.step, Isolator_controller_r5_PNP.csv]
